cbrillard/openspim.github.io/xopenspim/alignment_welcome.md

## Welcome to the OpenSPIM alignment guide!

There are different ways how to optimally align an OpenSPIM system and it can take time to get the hang of it. With two illumination sides and two detection objectives, as it is the case in an [X-OpenSPIM](https://openspim.org/table_of_parts_xopenspim), this task becomes particularly challenging. This site aims to provide a simple, reproducible way of how to...
-   [initially align the beam path along the rails (Part 1)](https://openspim.org/xopenspim/alignment_rails)
-   [visualize and tune the beam within the field of view of one or two cameras (Part 2)](https://openspim.org/xopenspim/alignment_FOV) 
-   [fine align the light-sheet for the sample using beads (Part 3)](https://openspim.org/xopenspim/alignment_sample)

The alignment guide was initially written for a [X-OpenSPIM publication](https://onlinelibrary.wiley.com/doi/10.1002/adbi.202101182) (2021) but can be applied in very much the same way to any L-, or T-OpenSPIM configuration.</br>
All renderings have been created by Charlène Brillard [(Tomancak Group)](https://www.mpi-cbg.de/research-groups/current-groups/pavel-tomancak/group-members/).

## Requirements
-   Make sure appropriate laser safety measures and training has been carried out and that µManager’s “Hardware configuration wizard” has been completed for at least one camera, one laser and the USB-4D stage.
-   A syringe to mount a glass capillary into the acquisition chamber. The capillary should be filled with agarose containing fluorescent beads that can be excited by the laser in use.
-   In case of an X-OpenSPIM acquisition chamber, modifications are needed to allow additional adjustments of the detections objectives (see chamber parts [here](https://openspim.org/table_of_parts_xopenspim))

**[Click here to start with part 1 of the alignment guide](https://openspim.org/xopenspim/alignment_rails)**

<figure align="center">
  
<figcaption> Top view rendering with labelled parts of the X-OpenSPIM used for the alignment guide.
</figcaption>
</figure> 

##  Quick menu:
- [Welcome site](https://openspim.org/xopenspim/alignment_welcome)
- [Part 1. Aligning the laser beam along the rails](https://openspim.org/xopenspim/alignment_rails)
- [Part 2. Visualizing and tuning the beam within the field of view of one or two cameras](https://openspim.org/xopenspim/alignment_FOV) 
- [Part 3. Fine alignment of the light-sheet for the sample using beads](https://openspim.org/xopenspim/alignment_sample)
