cbrillard/openspim.github.io/images/µOpenSPIM/ObjectiveHolder_ring/SampleChamber_4Objective_Nikon40x_Holder_ring-TailModif_M25.stp

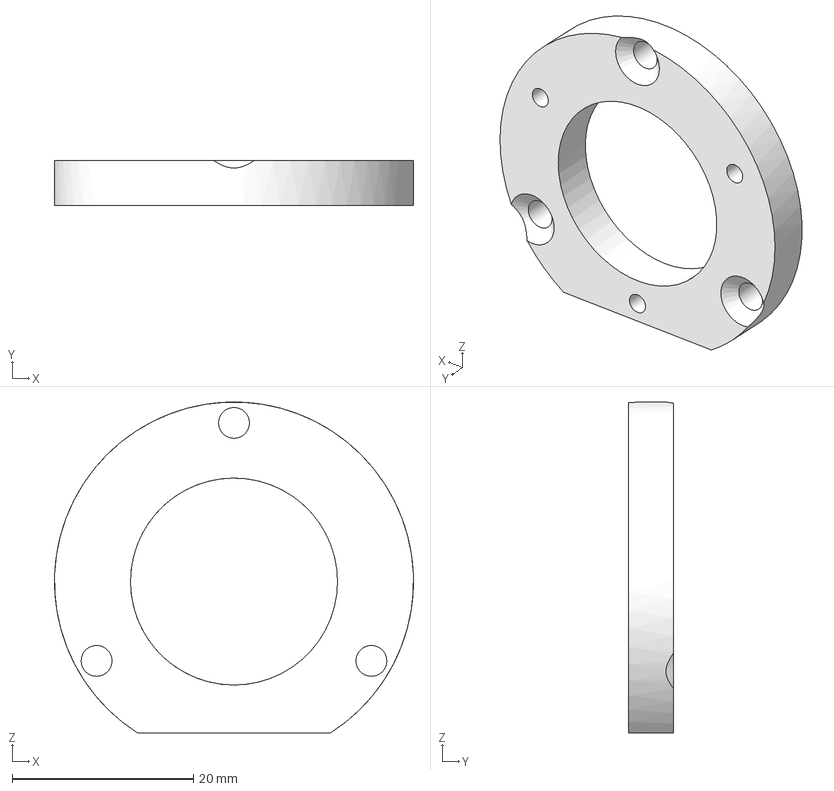
[picture p1: CAD file, 2023-03-16]
images/µOpenSPIM/ObjectiveHolder_ring/SampleChamber_4Objective_Nikon40x_Holder_ring-TailModif_M25.stp
39.6 x 5.00 x 36.5 mm
