cbrillard/openspim.github.io/(list of files, cad)

Other CAD files:
images/µOpenSPIM/ObjectiveHolder_ring/SampleChamber_4Objective_Nikon40x_Holder_ring-TailModif_M25.stl
