cbrillard/openspim.github.io/images/µOpenSPIM/ObjectiveHolder_ring/SampleChamber_4Objective_Nikon40x_Holder_ring-TailModif_M25.pdf

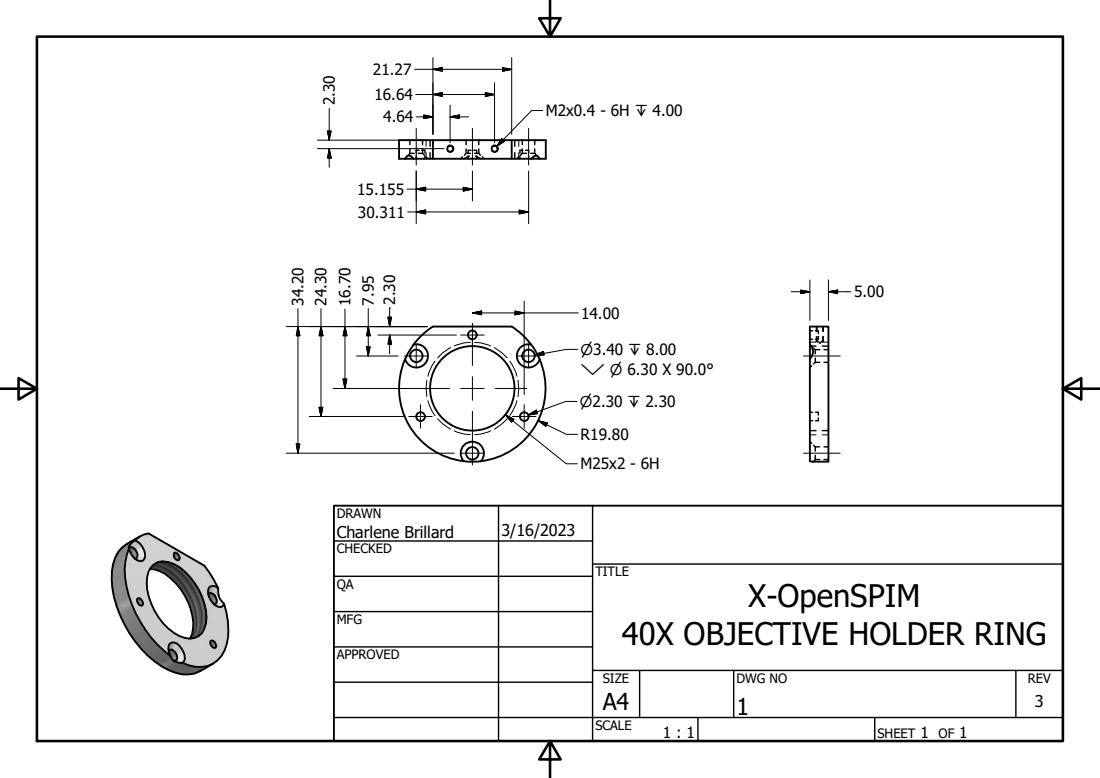
[picture p2: page 1]
SHEET 1 OF 1; DRAWN; CHECKED; MFG; APPROVED; Charlene Brillard; DWG NO 1; SIZE A4; SCALE; REV 3; X-OpenSPIM

TITLE
40X OBJECTIVE HOLDER RING
